tdarlic/24VDC_to_USB_voltage_converter/README.md

# 24VDC to USB voltage converter
Kicad project

Converts voltage from 9 to 24 volts from the boat batteries to 5V USB using Texas Instruments TPS54308
