tdarlic/24VDC_to_USB_voltage_converter/documents/3D_CVM_CVM_928814-1_A.pdf

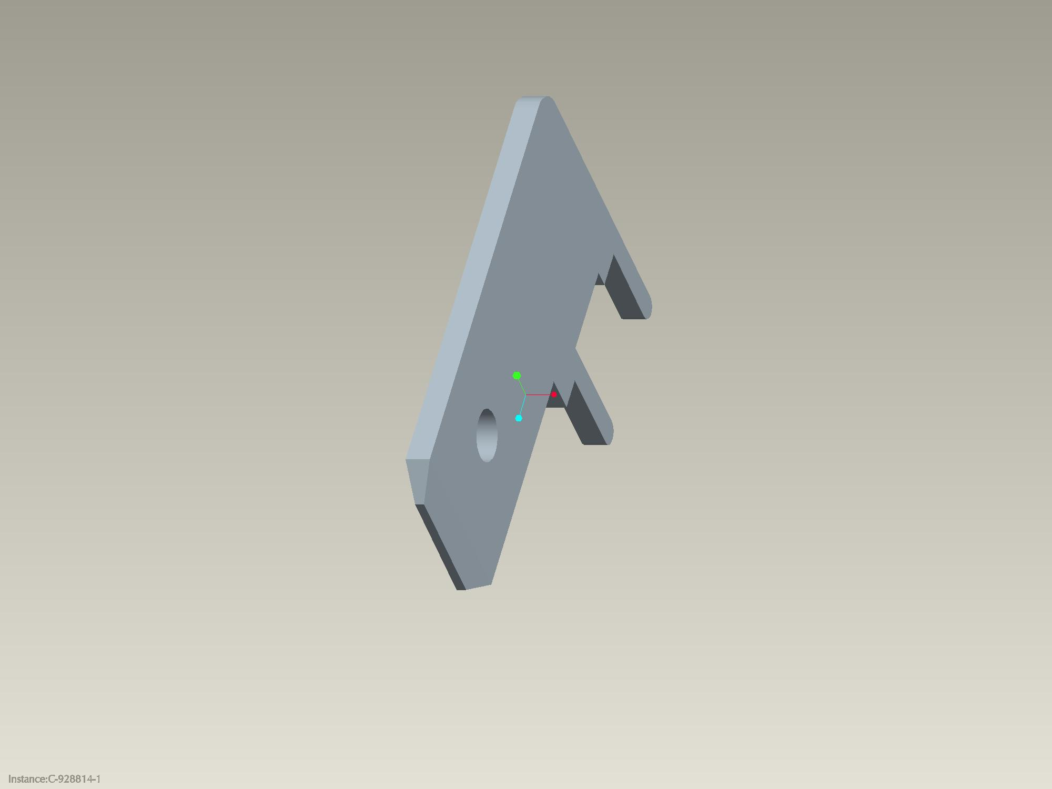
[picture p1: page 1]
