tdarlic/24VDC_to_USB_voltage_converter/documents/Efficiency.png

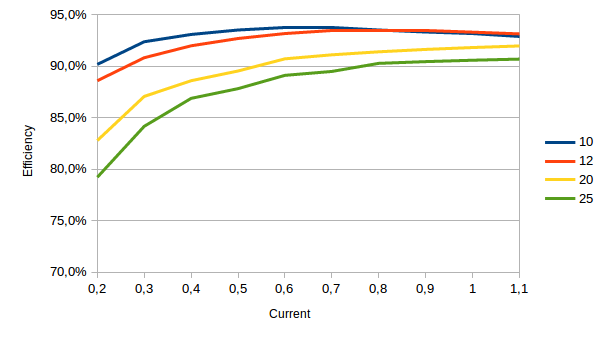
documents/Efficiency.png
