tdarlic/24VDC_to_USB_voltage_converter/documents/NewFile36_1.png

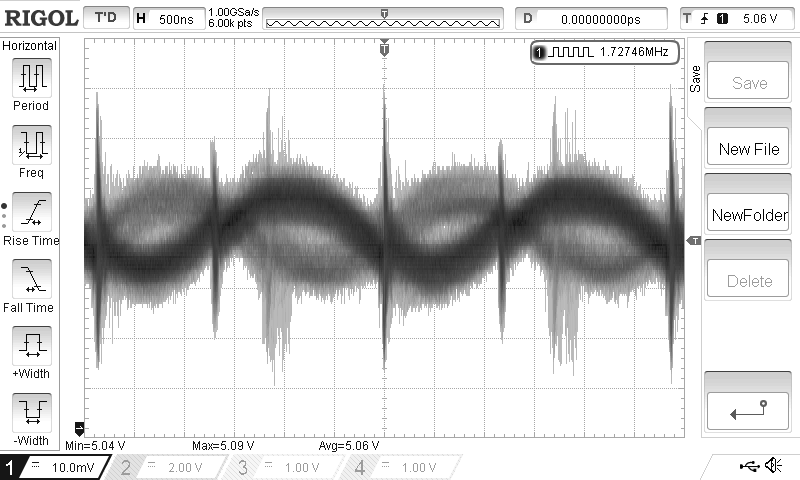
documents/NewFile36_1.png
