tdarlic/24VDC_to_USB_voltage_converter/documents/Basket_Feb20_0540AM.xls

SHOPPING BASKET
This is not an invoice
20-Feb-19 05:40:27
 | Mouser No | Mfr. No | Manufacturer | Customer No | Description | RoHS | Lifecycle | Order Qty. | Price (EUR) | Ext.: (EUR)
1 | 595-TPS54308DDCR | TPS54308DDCR | Texas Instruments | U1 | Switching Voltage Regulators 4.5V to 28V Input, 3A Output, Synchronous 350kHz FCCM Step-Down Converter 6-SOT-23-THIN -40 to 125 | RoHS Compliant | New Product | 50 | 1,15 € | 57,50 €
2 | 81-GRM21BR61E226ME4K | GRM21BR61E226ME44K | Murata | Cout | Multilayer Ceramic Capacitors MLCC - SMD/SMT 22UF 25V 20% 0805 | RoHS Compliant |  | 100 | 0,22 € | 22,00 €
3 | 81-GRT31CR61H106ME1L | GRT31CR61H106ME01L | Murata | Cin | Multilayer Ceramic Capacitors MLCC - SMD/SMT 1206 50Vdc 10uF X5R 20% | RoHS Compliant |  | 200 | 0,191 € | 38,20 €
4 | 755-SFR03EZPF1003 | SFR03EZPF1003 | ROHM Semiconductor | Rbft | Thick Film Resistors - SMD 0603 100Kohm 1% Anti-Sulfur AEC-Q200 | RoHS Compliant | New At Mouser | 60 | 0,069 € | 4,14 €
5 | 603-CC603KRX7R9BB104 | CC0603KRX7R9BB104 | Yageo |  | Multilayer Ceramic Capacitors MLCC - SMD/SMT 100nF 50V X7R 10% | RoHS Compliant By Exemption |  | 100 | 0,024 € | 2,40 €
6 | 530-SS-52100-001 | SS-52100-001 | Bel |  | USB Connectors USB 2.0 R Angle Recpt Type A solder | RoHS Compliant | New Product | 50 | 0,264 € | 13,20 €
7 | 530-0679L1500-05 | 0679L1500-05 | Bel |  | Surface Mount Fuses 1.5 A, 125 VAC / VDC | RoHS Compliant By Exemption |  | 60 | 0,191 € | 11,46 €
8 | 621-P4SMAJ30ADF-13 | P4SMAJ30ADF-13 | Diodes Incorporated |  | ESD Suppressors / TVS Diodes Transient Voltage Suppressor |  |  | 50 | 0,242 € | 12,10 €
9 | 652-SDE0805A-120M | SDE0805A-120M | Bourns |  | Fixed Inductors 12uH 20% SMD 0805 AEC-Q200 | RoHS Compliant |  | 50 | 0,308 € | 15,40 €
10 | 571-928814-1 | 928814-1 | TE Connectivity |  | Terminals GDS FLACHSTECK 6.3 | RoHS Compliant |  | 110 | 0,128 € | 14,08 €
11 | 603-AC0603FR-0713K3L | AC0603FR-0713K3L | Yageo |  | Thick Film Resistors - SMD AEC-Q200 | RoHS Compliant |  | 60 | 0,019 € | 1,14 €
12 | 652-CR0603FX-1372ELF | CR0603-FX-1372ELF | Bourns |  | Thick Film Resistors - SMD 13.7K 1% 1/10W | RoHS Compliant By Exemption |  | 60 | 0,017 € | 1,02 €
13 | 863-CPH6341-TL-W | CPH6341-TL-W | ON Semiconductor |  | MOSFET PCH 4V DRIVE SERIES | RoHS Compliant |  | 100 | 0,14 € | 14,00 €
By submitting your order you agree to these terms and conditions. (https://hr.mouser.com/saleterms) |  |  |  |  |  |  |  |  | Merchandise Total: | 206,64 €
Prices are reflected at the date and time shown. |  |  |  |  |  |  |  |  | Delivery Charge: | 0,00 €
