tdarlic/24VDC_to_USB_voltage_converter/3D/femaleThruHoleUSB.stp

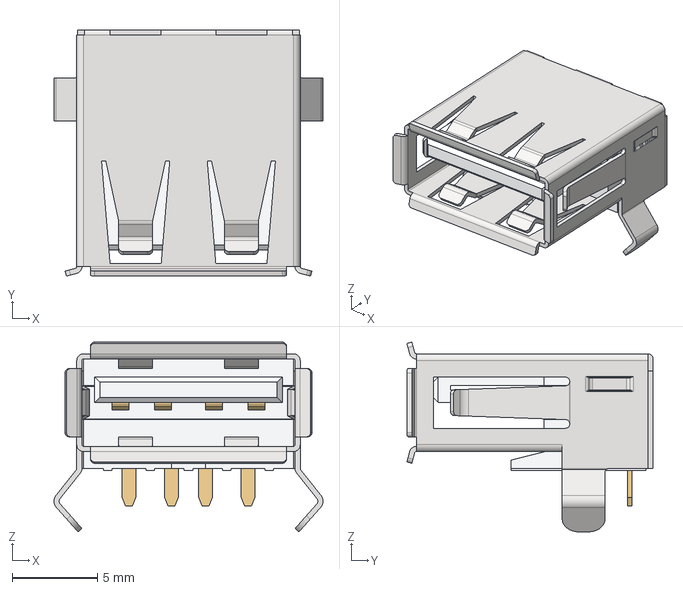
[picture p4: CAD file, 2019-02-21]
3D/femaleThruHoleUSB.stp
15.8 x 14.4 x 11.1 mm
