tdarlic/24VDC_to_USB_voltage_converter/3D/User Library-Inductor_SDE0805.stp

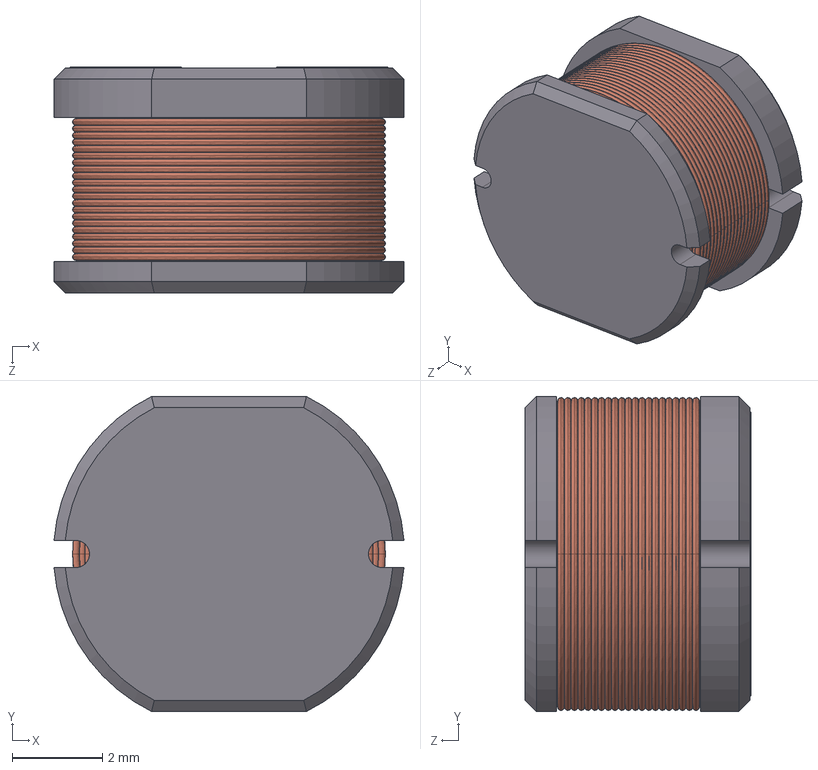
[picture p5: CAD file, 2019-02-21]
3D/User Library-Inductor_SDE0805.stp
7.78 x 7.00 x 5.02 mm
User Library-Inductor_SDE0805_Array002
User Library-Inductor_SDE0805_Array001
User Library-Inductor_SDE0805_Pad003
User Library-Inductor_SDE0805_Array
User Library-Inductor_SDE0805_Cut002
