tdarlic/24VDC_to_USB_voltage_converter/3D/c-928814-1-a-3d.stp

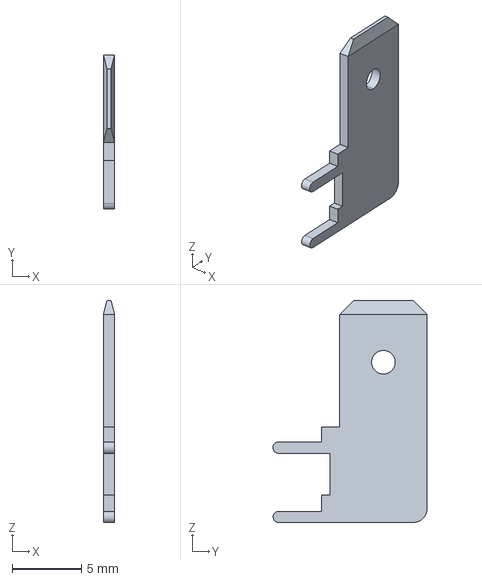
[picture p6: CAD file, 2019-02-21]
3D/c-928814-1-a-3d.stp
0.8 x 11.1 x 16.0 mm
