tdarlic/24VDC_to_USB_voltage_converter/24VDC_to_USB_voltage_converter.pdf

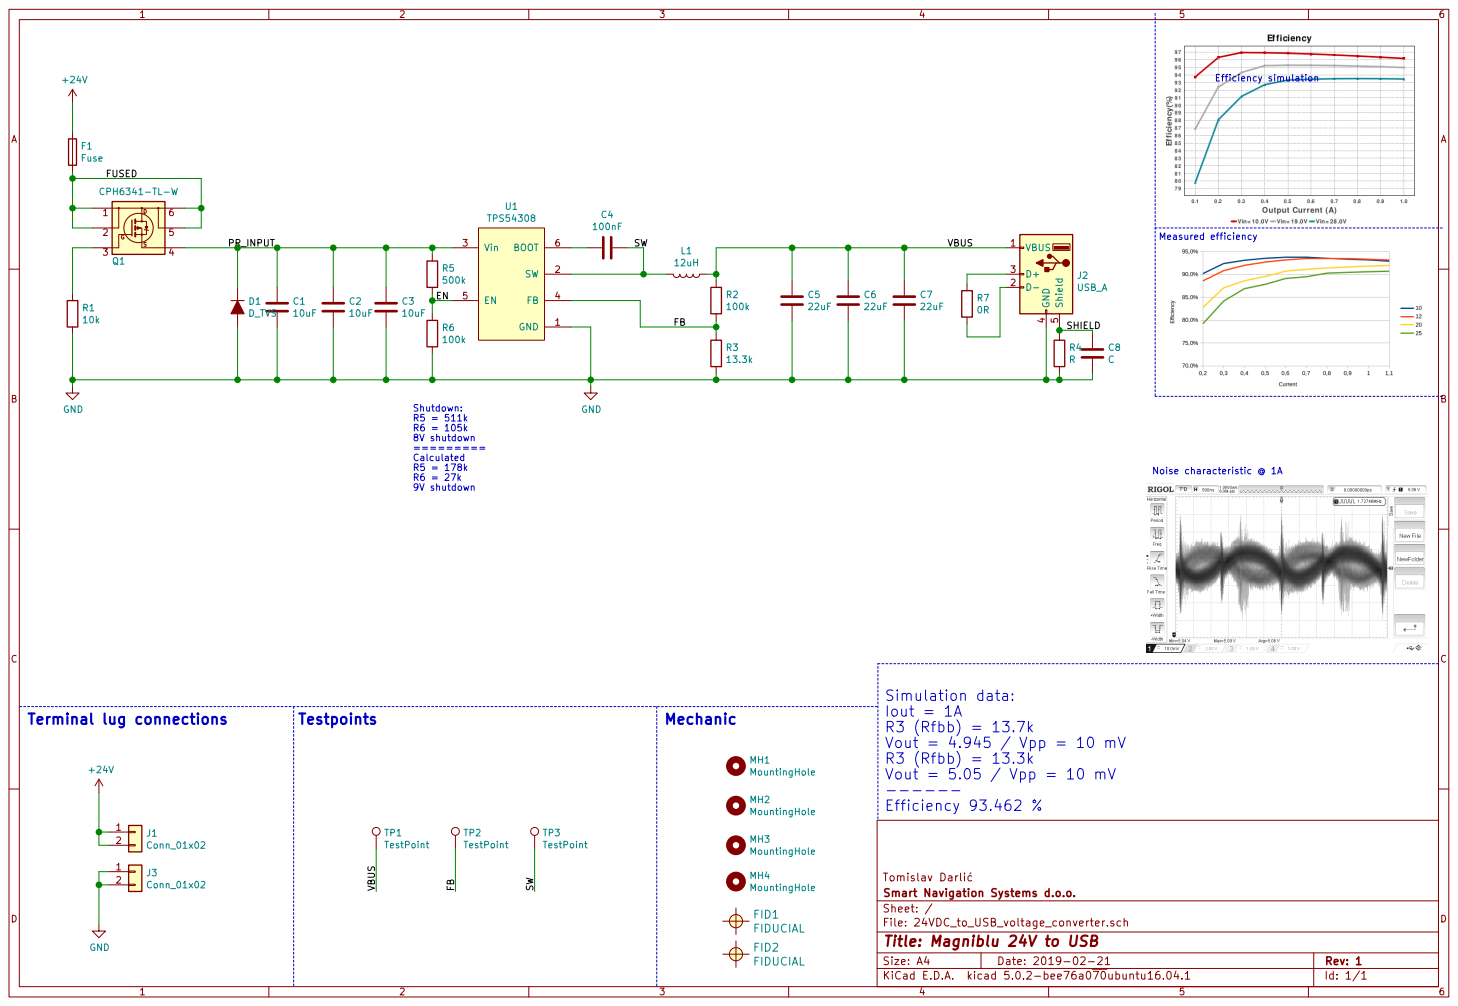
[picture p13: page 1]

Efficiency simulation Noise characteristic @ 1A

J3Conn_01x02 +24V GND Terminal lug connections

File: 24VDC_to_USB_voltage_converter.sch Sheet: / Smart Navigation Systems d.o.o. Tomislav Darli

Id: 1/1 Title: Magniblu 24V to USB
