tdarlic/24VDC_to_USB_voltage_converter/24VDC_to_USB_voltage_converter.kicad_pcb

## KiCad design 24VDC_to_USB_voltage_converter.kicad_pcb (2019-03-07)

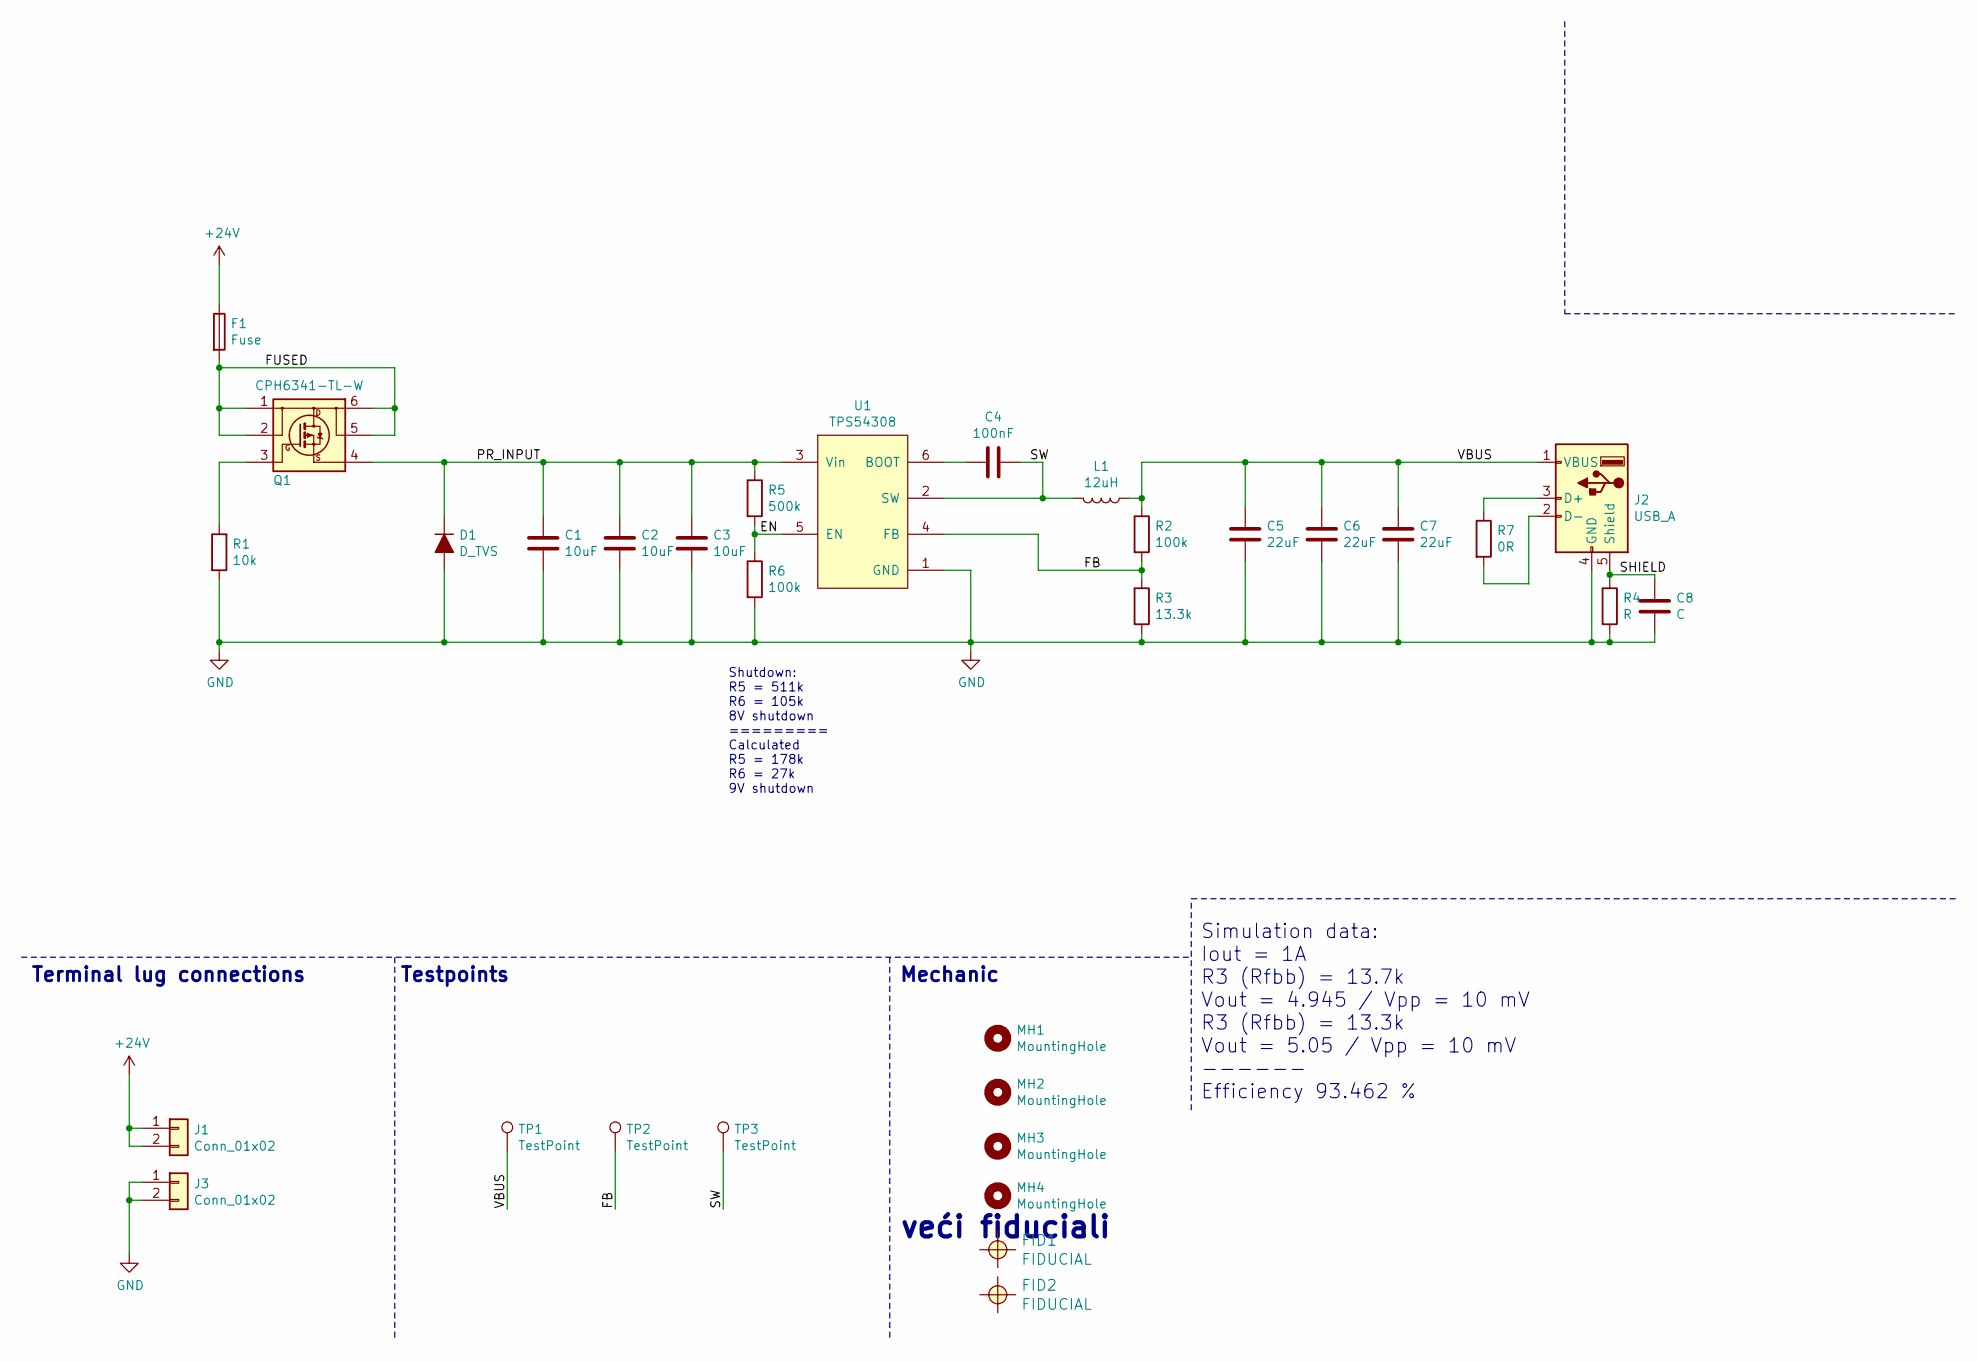
[picture p14: schematic 24VDC_to_USB_voltage_converter.sch, Magniblu 24V to USB]

Parts:
C1, C2, C3: 10uF; C_1206_3216Metric; Mouser code 81-GRT31CR61H106ME1L
C4: 100nF; C_0603_1608Metric; Mouser code 603-CC603KRX7R9BB104
C5, C6, C7: 22uF; R_0805_2012Metric; Mouser code 81-GRM21BR61E226ME4K
C8: C; C_0603_1608Metric
D1: D_TVS; D-FLAT; Mouser code 621-P4SMAJ30ADF-13
F1: Fuse; Fuse_2410_(6125_metric); Mouser code 530-0679L1500-05
FID1, FID2: FIDUCIAL
J1, J3: Conn_01x02; TE FASTON 250 TAB 928814-1; Mouser code 571-928814-1
J2: USB_A; BEL-USBA-SS-52100-001; Mouser code 530-SS-52100-001
L1: 12uH; L_Wuerth_WE-PD2-Typ-L; Mouser code 652-SDE0805A-120M
MH1, MH2, MH3, MH4: MountingHole; MountingHole_2.5mm
Q1: CPH6341-TL-W; SOT-23-6_Handsoldering; Mouser code 863-CPH6341-TL-W
R1: 10k; R_0603_1608Metric
R2: 100k; R_0603_1608Metric; Mouser code 755-SFR03EZPF1003
R3: 13.3k; R_0603_1608Metric; Mouser code 603-AC0603FR-0713K3L
R4: R; R_0603_1608Metric
R5: 500k; R_0603_1608Metric
R6: 100k; R_0603_1608Metric
R7: 0R; R_0603_1608Metric
TP1, TP2, TP3: TestPoint; TestPoint_Pad_D1.5mm
U1: TPS54308; SOT-23-6_Handsoldering; Mouser code 595-TPS54308DDCR

Connections:
+24V: F1.1, J1.1, J1.2
/EN: R5.2, R6.1, U1.5 (EN)
/FB: R2.2, R3.1, TP2.1, U1.4 (FB)
/FUSED: F1.2, Q1.1 (D), Q1.2 (D), Q1.5 (D), Q1.6 (D)
/PR_INPUT: C1.1, C2.1, C3.1, D1.1 (K), Q1.4 (S), R5.1, U1.3 (Vin)
/SHIELD: C8.1, J2.5 (Shield), R4.1
/SW: C4.1, L1.2, TP3.1, U1.2 (SW)
/VBUS: C5.1, C6.1, C7.1, J2.1 (VBUS), L1.1, R2.1, TP1.1
GND: C1.2, C2.2, C3.2, C5.2, C6.2, C7.2, C8.2, D1.2 (A), J2.4 (GND), J3.1, J3.2, R1.2, R3.2, R4.2, R6.2, U1.1 (GND)
unnamed: C4.2, U1.6 (BOOT)
unnamed: J2.2 (D-), R7.2
unnamed: J2.3 (D+), R7.1
unnamed: Q1.3 (G), R1.1

Notes on the sheet:
Terminal lug connections
Simulation data: Iout = 1A R3 (Rfbb) = 13.7k Vout = 4.945 / Vpp = 10 mV R3 (Rfbb) = 13.3k Vout = 5.05 / Vpp = 10 mV ------ Efficiency 93.462 %
Testpoints
Shutdown: R5 = 511k R6 = 105k 8V shutdown ========= Calculated R5 = 178k R6 = 27k 9V shutdown
Mechanic
veći fiduciali

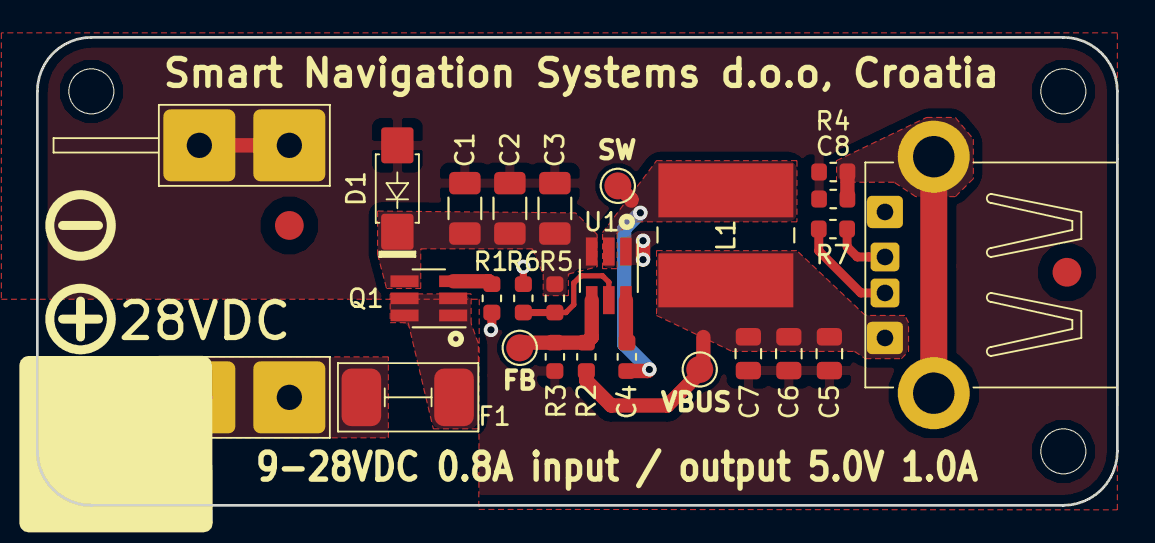
[picture p15: board 24VDC_to_USB_voltage_converter.kicad_pcb from above]

Board: 2 copper layers, 60.0 x 26.0 mm, 32 parts (0 on the bottom side), 13 nets.
