tdarlic/24VDC_to_USB_voltage_converter/(commit log)

2019-02-21 Adding PDF schematic
2019-02-28 Adding final changes and exporting Gerbers
    [24VDC_to_USB_voltage_converter-B.Cu.gbl, 24VDC_to_USB_voltage_converter-B.Mask.gbs, 24VDC_to_USB_voltage_converter-B.SilkS.gbo, 24VDC_to_USB_voltage_converter-B.SilkS.gbr, 24VDC_to_USB_voltage_converter-Edge.Cuts.gm1, 24VDC_to_USB_voltage_converter-F.Cu.gtl, 24VDC_to_USB_voltage_converter-F.Mask.gts, 24VDC_to_USB_voltage_converter-F.SilkS.gto]
2019-03-07 Finishing the board and creating gerbers for ordering
    [24VDC_to_USB_voltage_converter-B.Cu.gbl, 24VDC_to_USB_voltage_converter-B.Mask.gbs, 24VDC_to_USB_voltage_converter-B.SilkS.gbo, 24VDC_to_USB_voltage_converter-Edge.Cuts.gm1, 24VDC_to_USB_voltage_converter-F.Cu.gtl, 24VDC_to_USB_voltage_converter-F.Mask.gts, 24VDC_to_USB_voltage_converter-F.SilkS.gto, 24VDC_to_USB_voltage_converter-NPTH.drl]
2019-03-07 Adding short resistor between d+ and d-, small changes in PCB
    [24VDC_to_USB_voltage_converter.kicad_pcb, 24VDC_to_USB_voltage_converter.sch]
2019-03-07 Adding PDF file, removing comments from schematic, adding scope image in schematic
    [24VDC_to_USB_voltage_converter.sch]
2019-03-08 Adding noise characteristic to schematic and rearranging some items in schematic
    [24VDC_to_USB_voltage_converter.sch]
2019-03-25 Adding one comment to schematic
    [24VDC_to_USB_voltage_converter.sch]
